utk1017/arduino-mppt-controller/(notices)

Notices in the files:
README.md:
License: MIT
